Brandochili/CS207_Maker_Project/images/20181024_132314.jpg

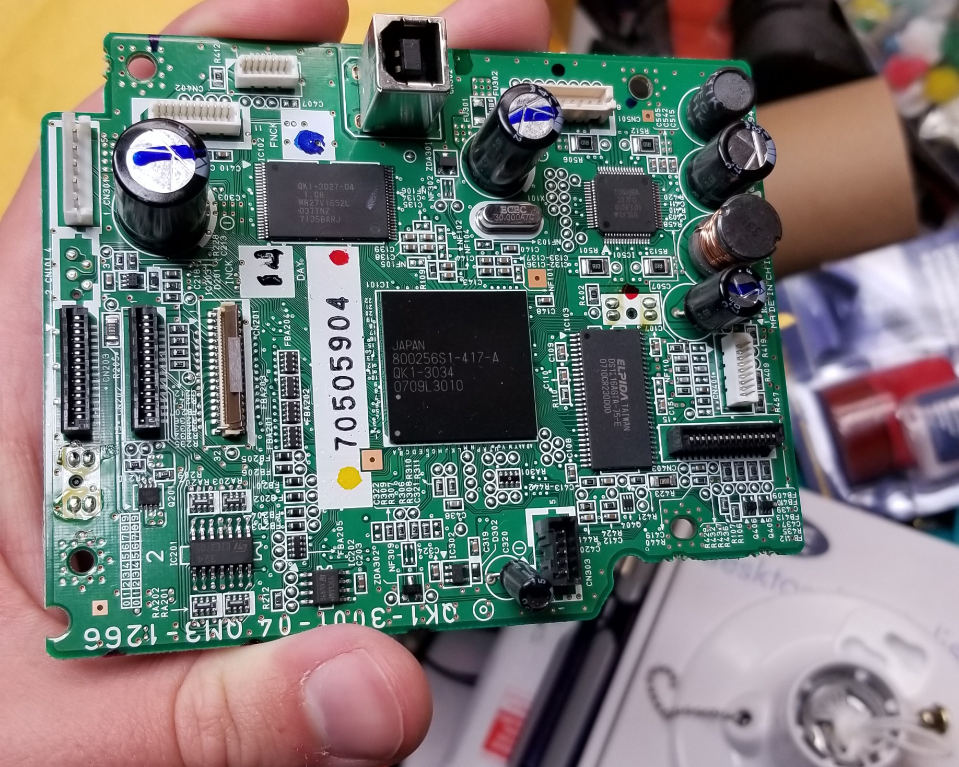
images/20181024_132314.jpg
