Brandochili/CS207_Maker_Project/images/20181102_145457.jpg

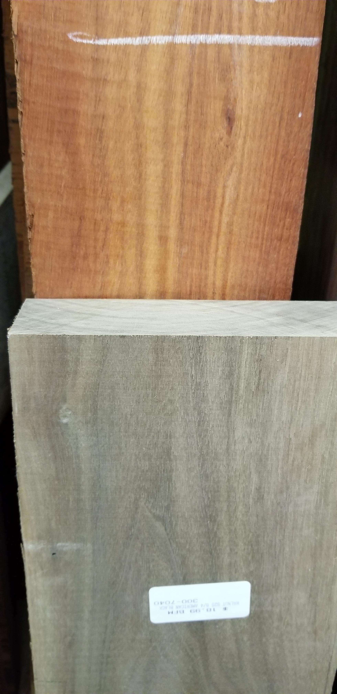
images/20181102_145457.jpg
