Brandochili/CS207_Maker_Project/images/20181102_200749.jpg

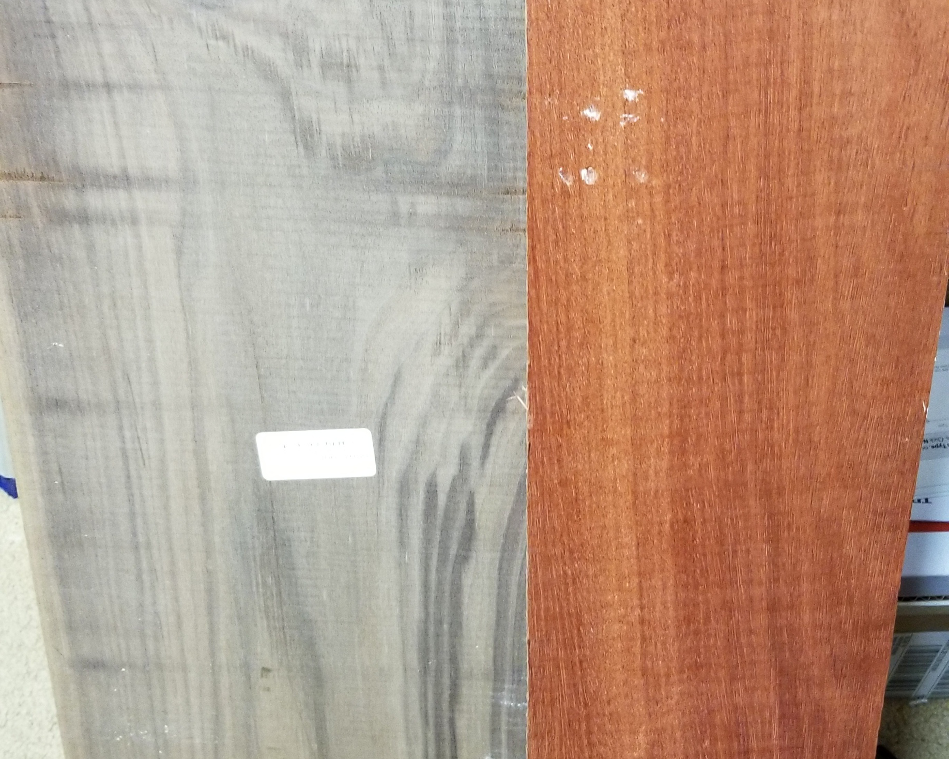
images/20181102_200749.jpg
