Brandochili/CS207_Maker_Project/images/20181112_192328.jpg

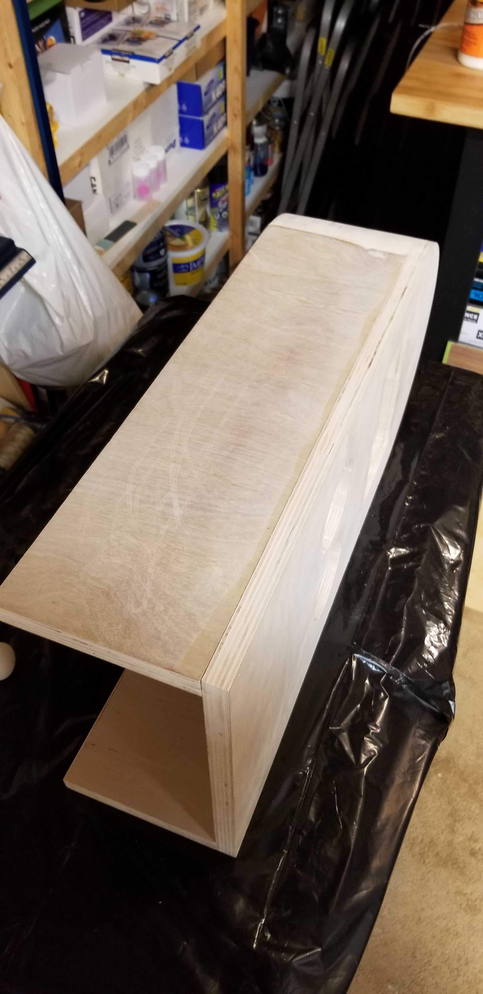
images/20181112_192328.jpg
