Brandochili/CS207_Maker_Project/images/20181112_192332.jpg

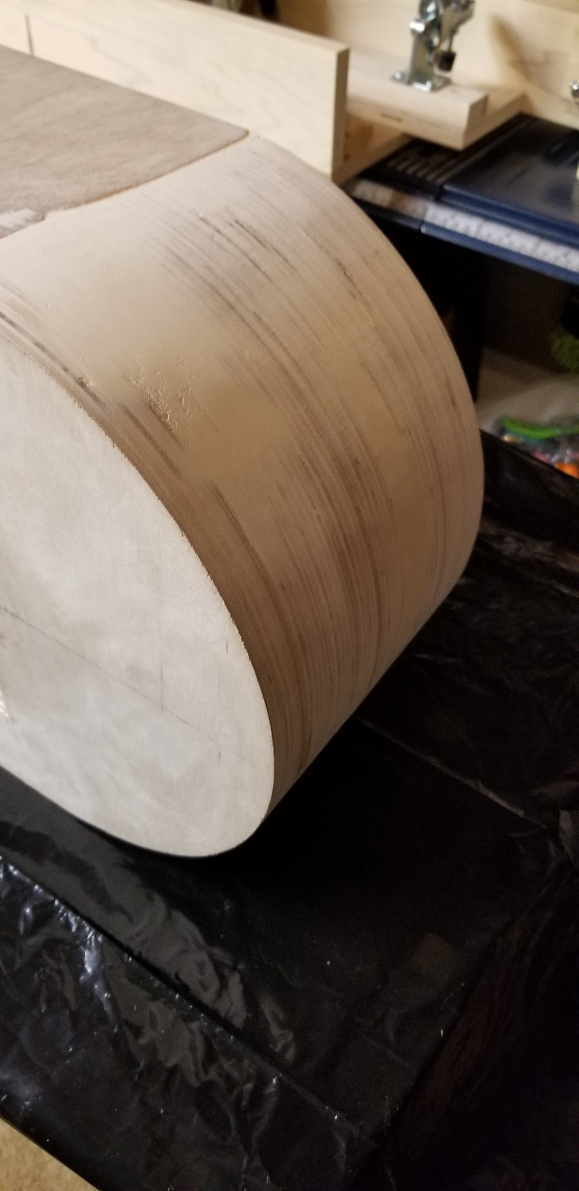
images/20181112_192332.jpg
