Brandochili/CS207_Maker_Project/images/20181112_212635.jpg

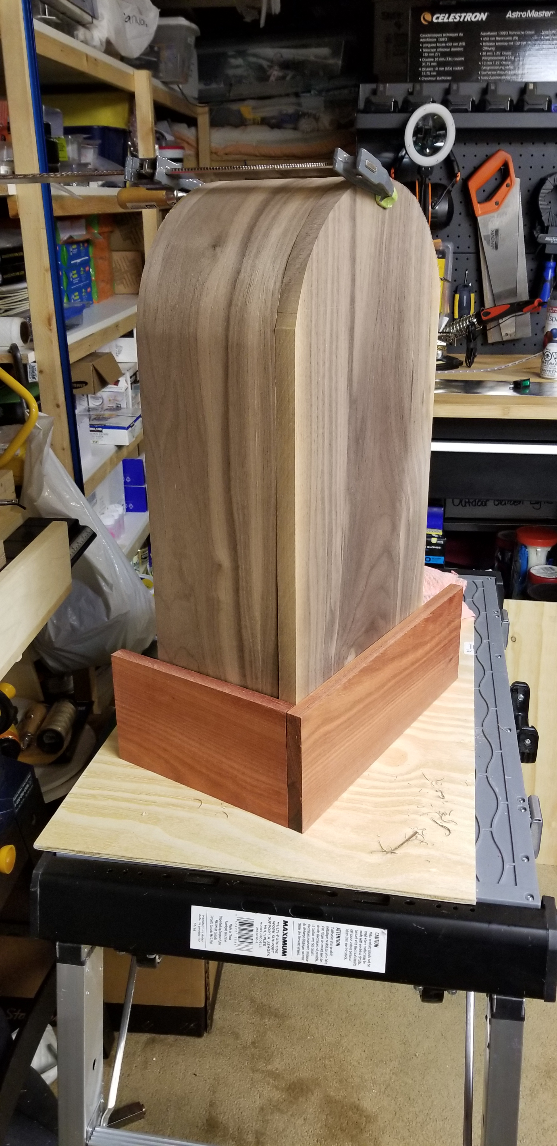
images/20181112_212635.jpg
