Brandochili/CS207_Maker_Project/images/20181119_145951.jpg

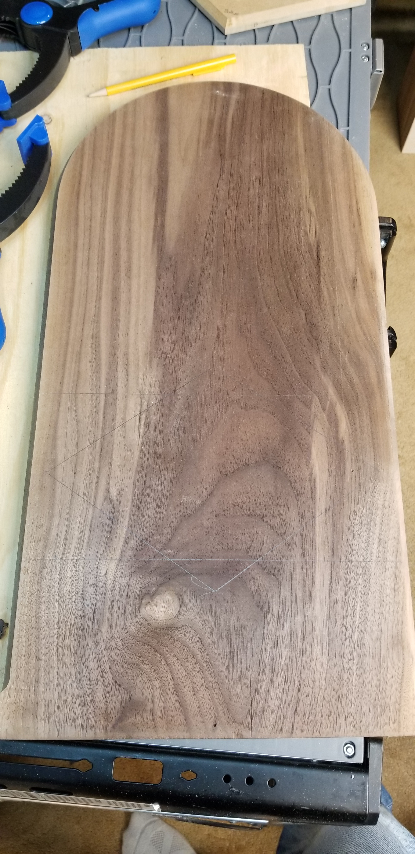
images/20181119_145951.jpg
