Brandochili/CS207_Maker_Project/images/20181119_150005.jpg

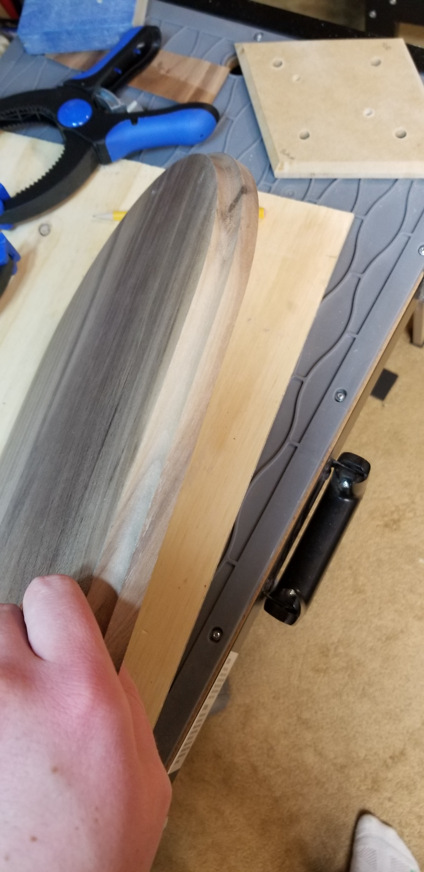
images/20181119_150005.jpg
