Brandochili/CS207_Maker_Project/images/20181119_150015.jpg

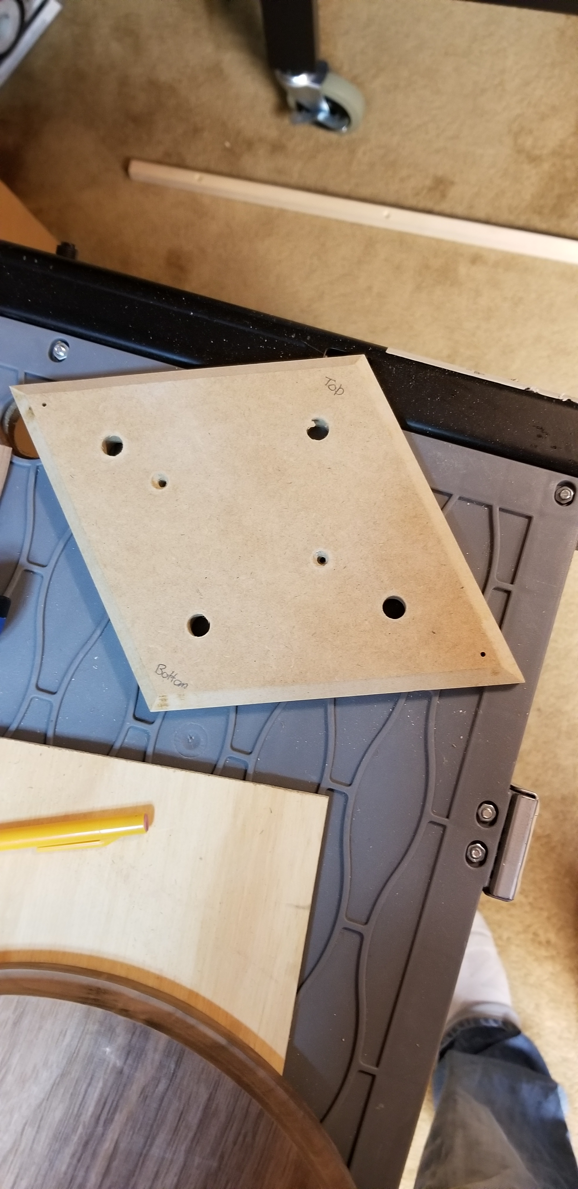
images/20181119_150015.jpg
