Brandochili/CS207_Maker_Project/images/20181119_150020.jpg

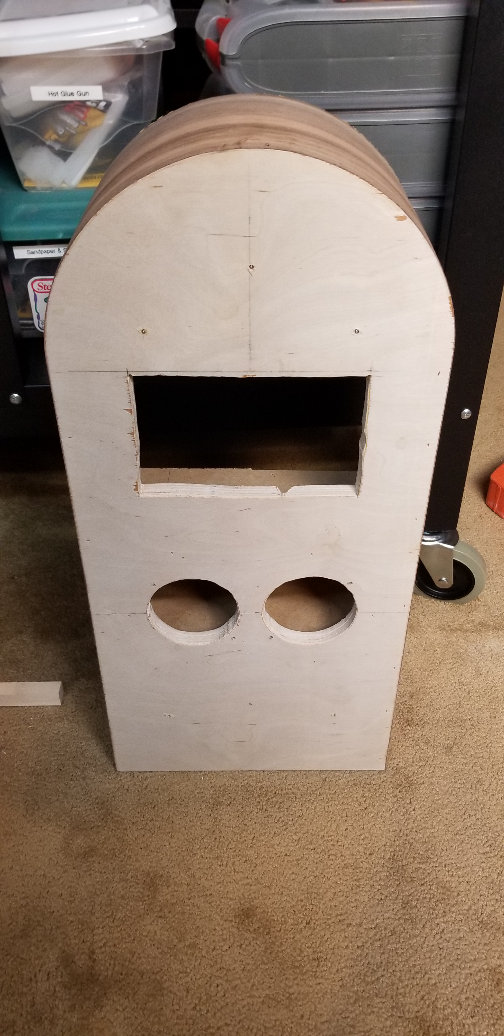
images/20181119_150020.jpg
