Brandochili/CS207_Maker_Project/images/20181119_150029.jpg

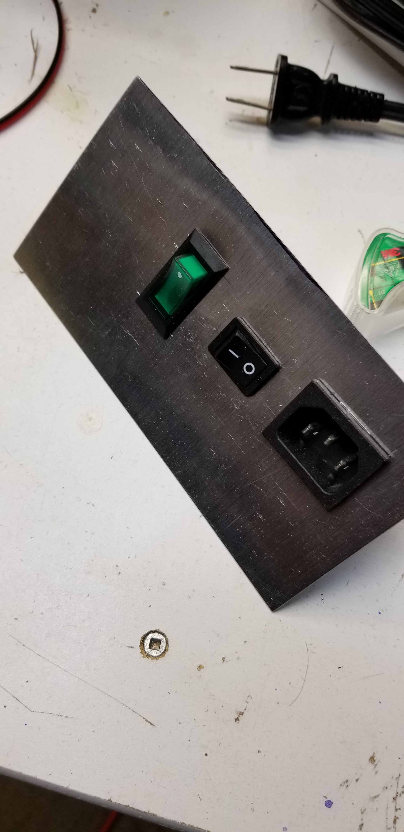
images/20181119_150029.jpg
