Brandochili/CS207_Maker_Project/images/20181119_165003.jpg

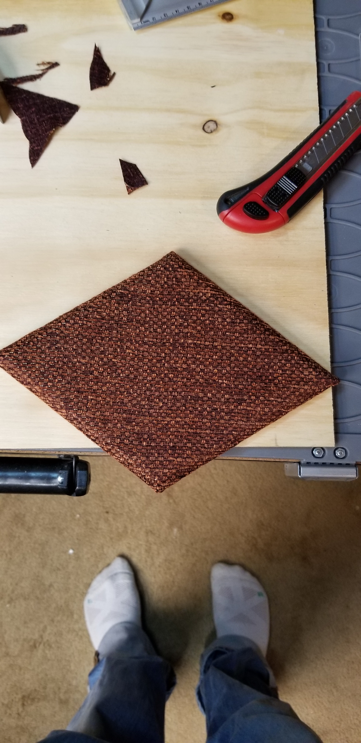
images/20181119_165003.jpg
