Brandochili/CS207_Maker_Project/images/20181119_165007.jpg

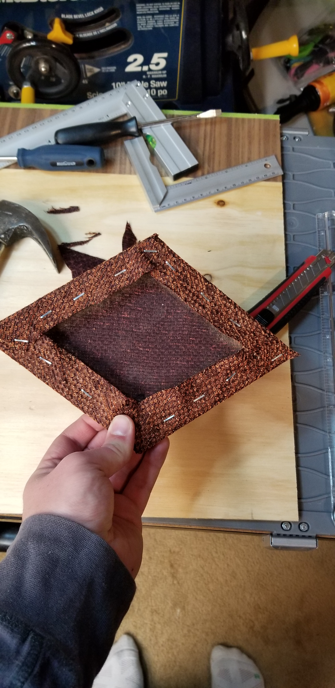
images/20181119_165007.jpg
