Brandochili/CS207_Maker_Project/images/20181119_201047.jpg

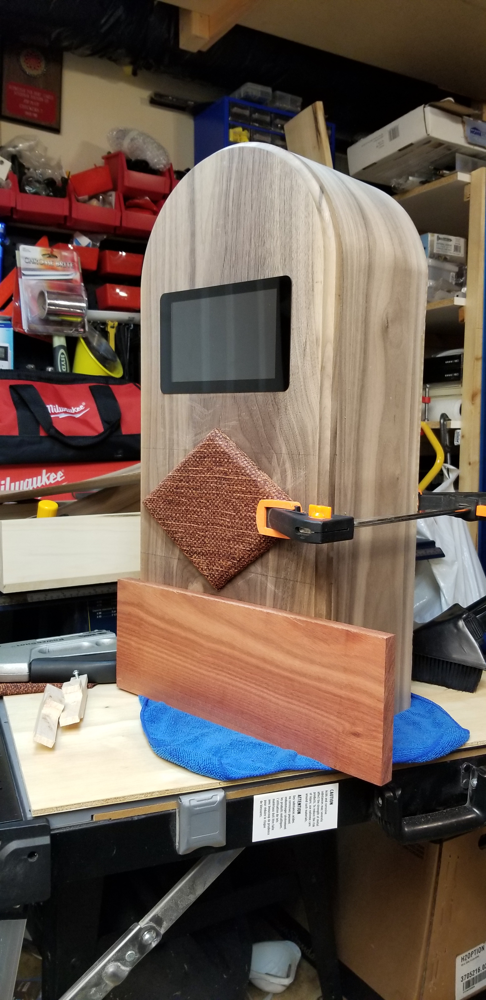
images/20181119_201047.jpg
