Brandochili/CS207_Maker_Project/images/20181120_113831.jpg

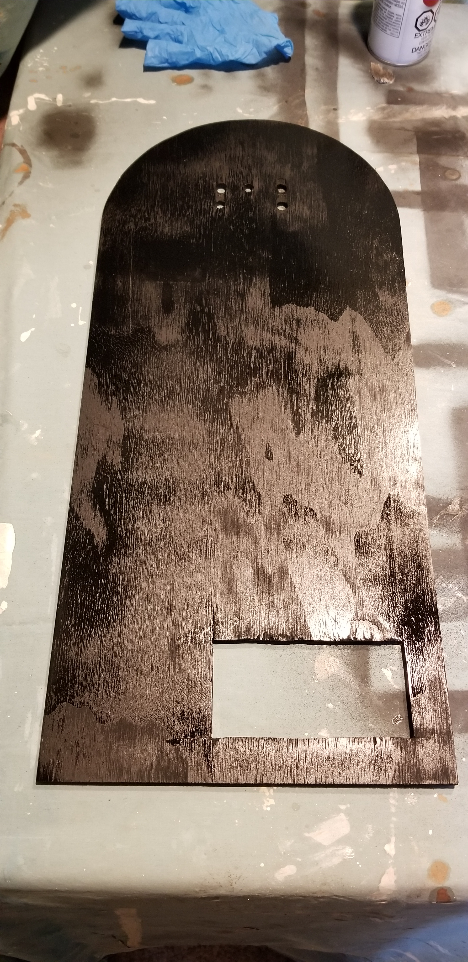
images/20181120_113831.jpg
