Brandochili/CS207_Maker_Project/images/20181120_113836.jpg

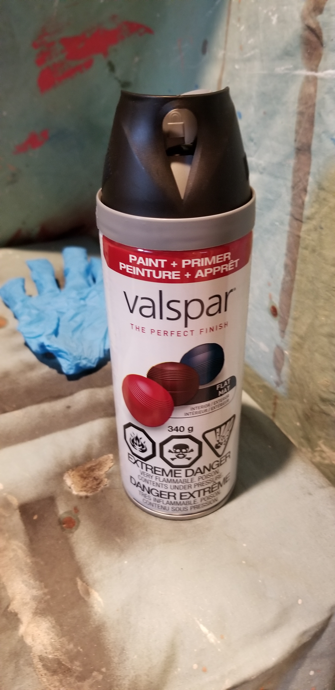
images/20181120_113836.jpg
