Brandochili/CS207_Maker_Project/images/20181122_113509.jpg

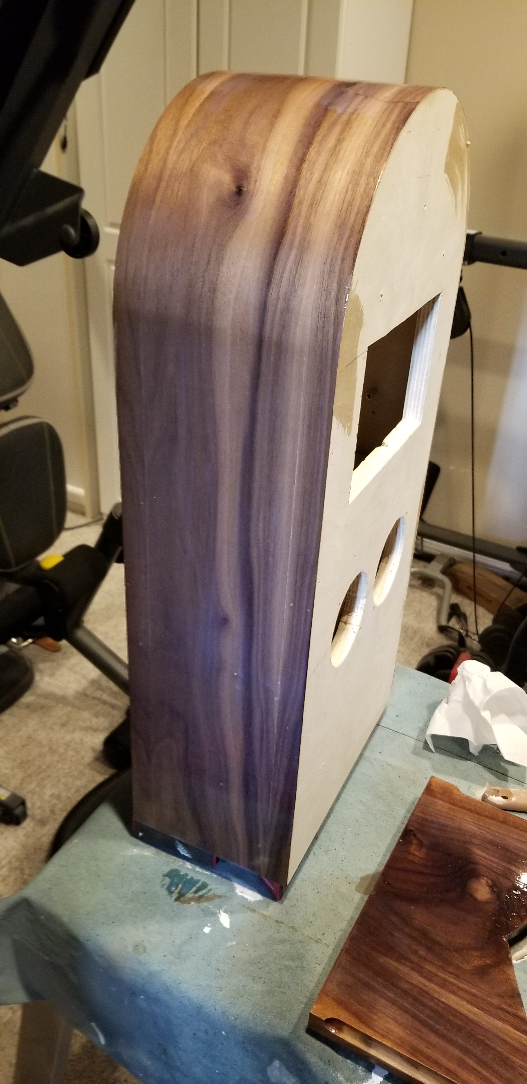
images/20181122_113509.jpg
