Brandochili/CS207_Maker_Project/images/20181122_113522.jpg

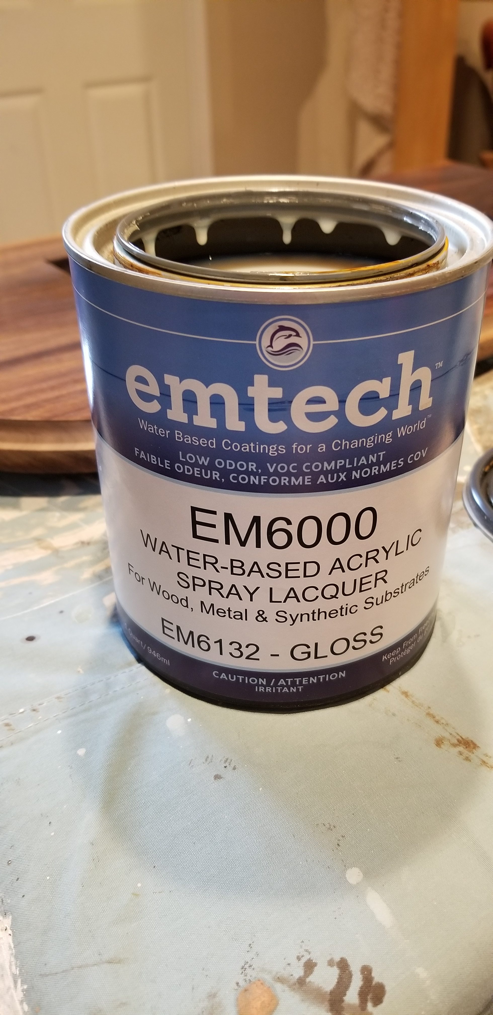
images/20181122_113522.jpg
