Brandochili/CS207_Maker_Project/images/20181122_113532.jpg

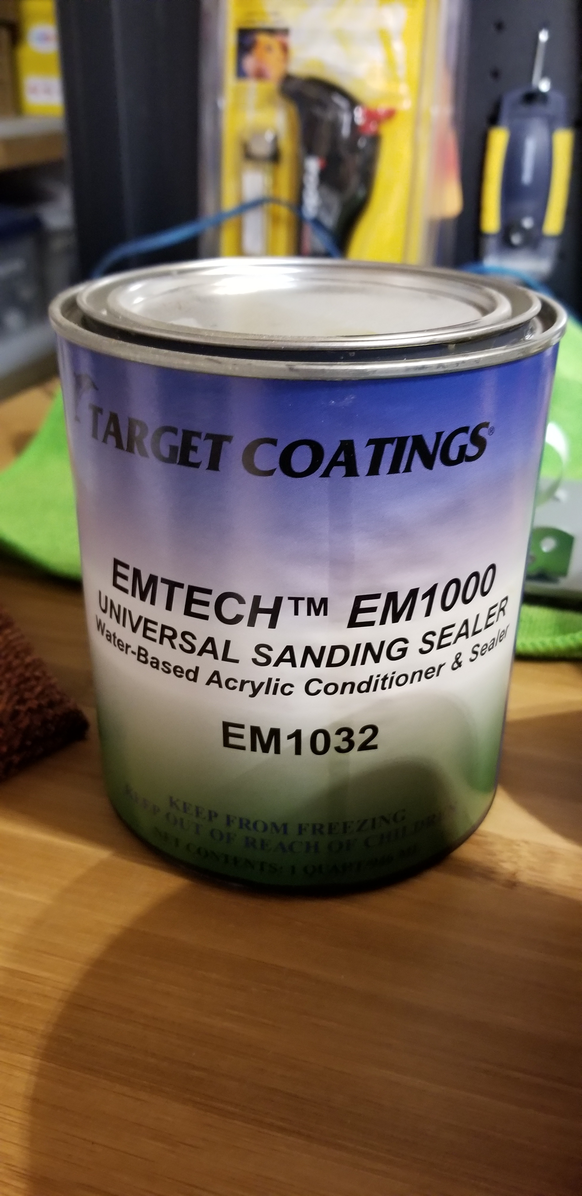
images/20181122_113532.jpg
