Brandochili/CS207_Maker_Project/images/20181123_001641.jpg

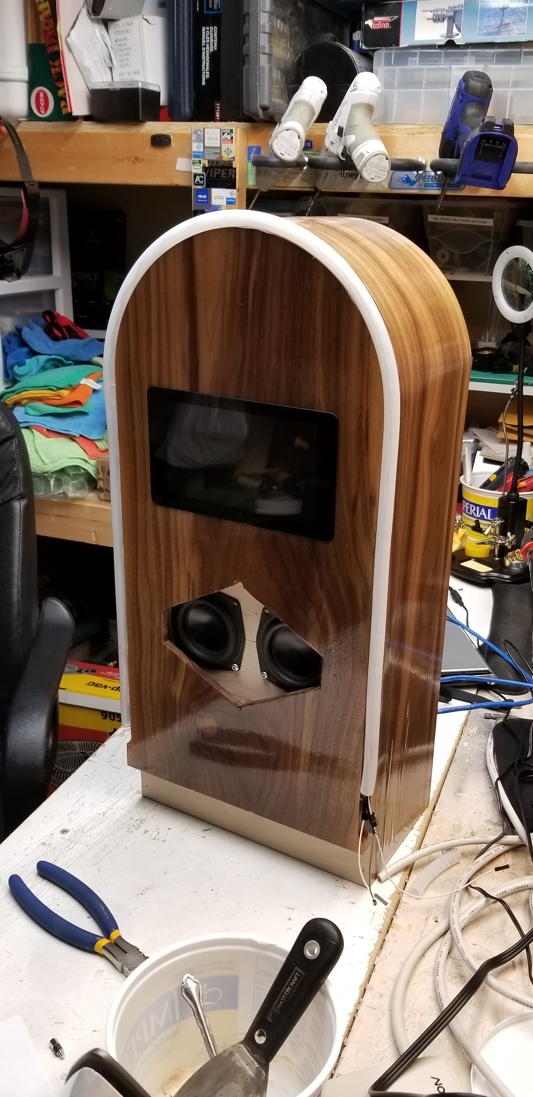
images/20181123_001641.jpg
