Brandochili/CS207_Maker_Project/images/20181125_210042_resized.jpg

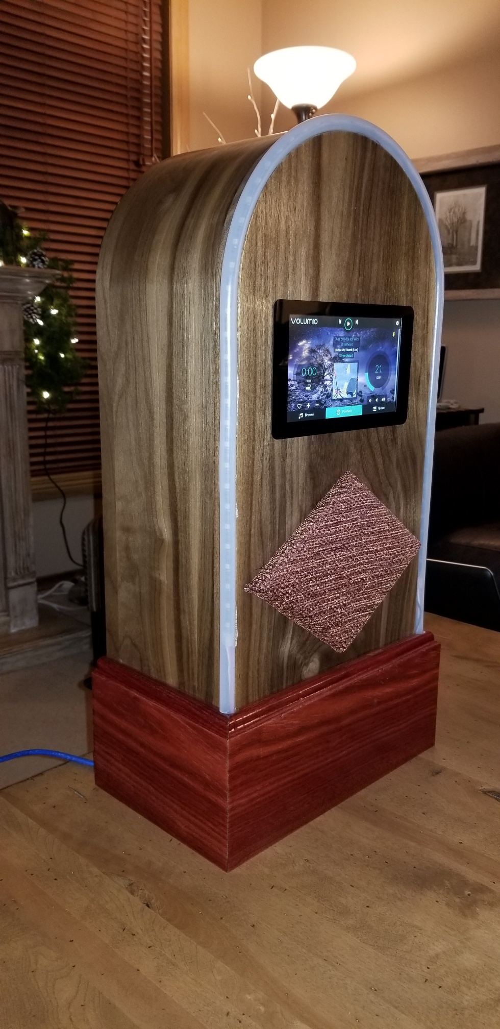
images/20181125_210042_resized.jpg
